cliffporter/SD2-StudyBuddy/Website/pictures/idris-photo.jpg

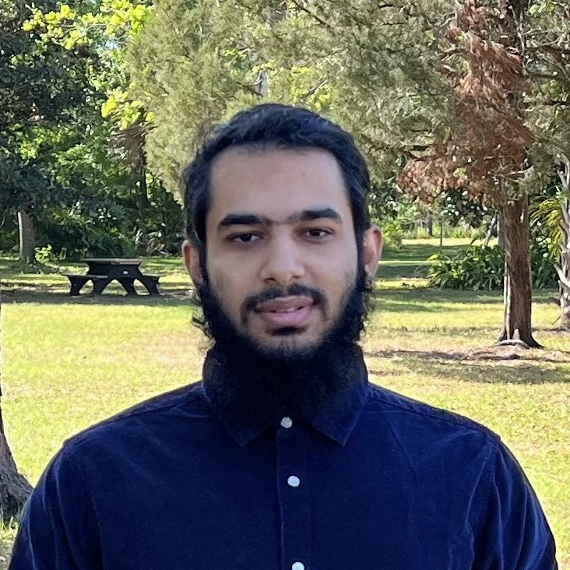
Website/pictures/idris-photo.jpg
