cliffporter/SD2-StudyBuddy/Website/pictures/locker-pcb.jpg

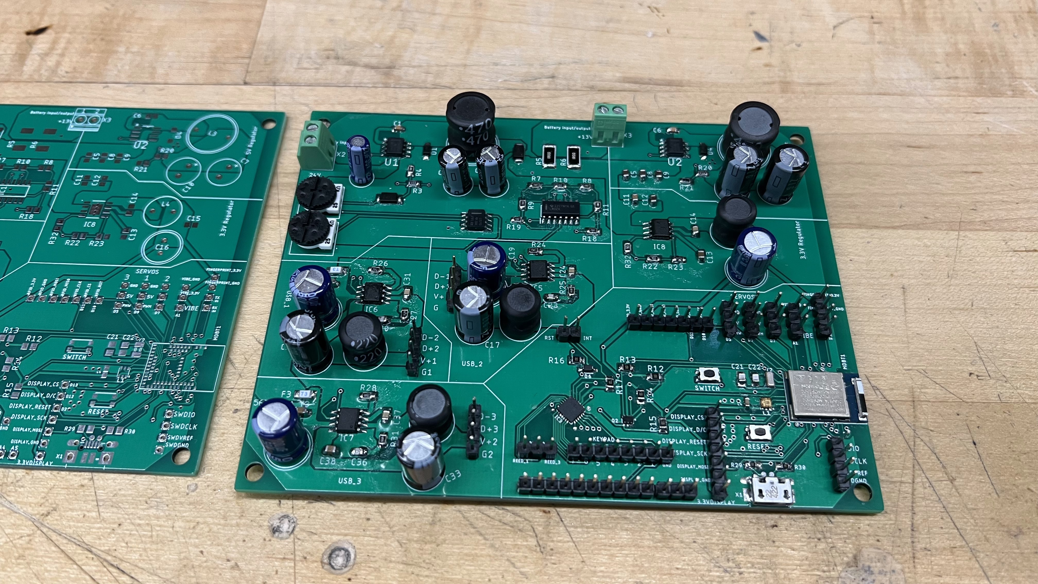
Website/pictures/locker-pcb.jpg
