cliffporter/SD2-StudyBuddy/Website/documents/sd1-dc-thumb.png

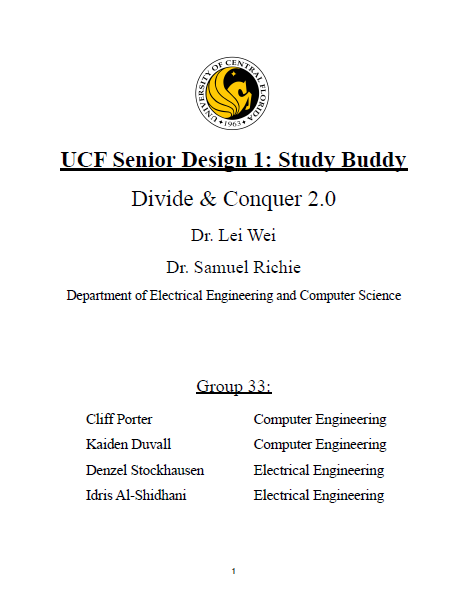
Website/documents/sd1-dc-thumb.png
