cliffporter/SD2-StudyBuddy/Website/documents/sd1-final-doc-thumb.png

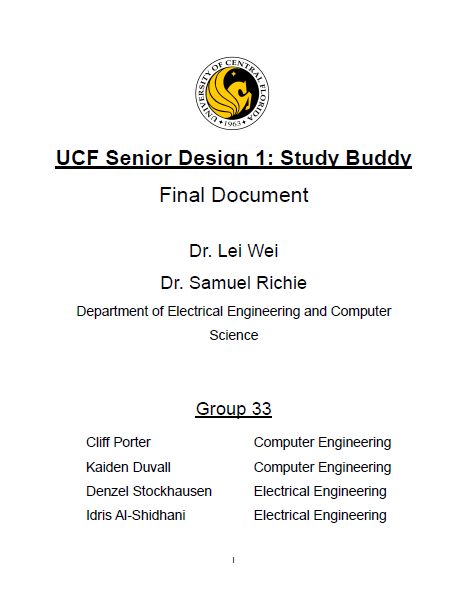
Website/documents/sd1-final-doc-thumb.png
