cliffporter/SD2-StudyBuddy/Website/documents/sd2-8-page-thumb.png

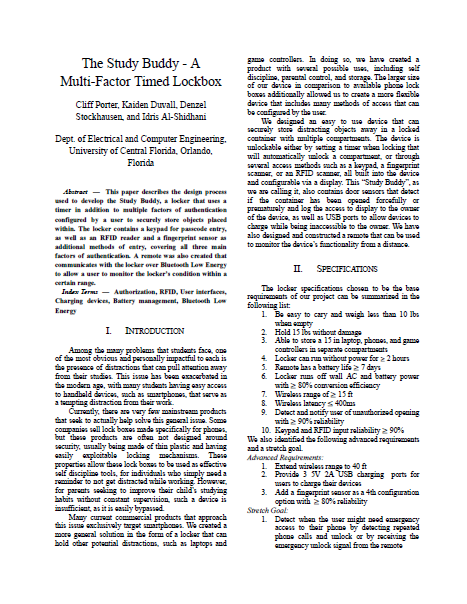
Website/documents/sd2-8-page-thumb.png
