cliffporter/SD2-StudyBuddy/Website/documents/sd2-pres-thumb.png

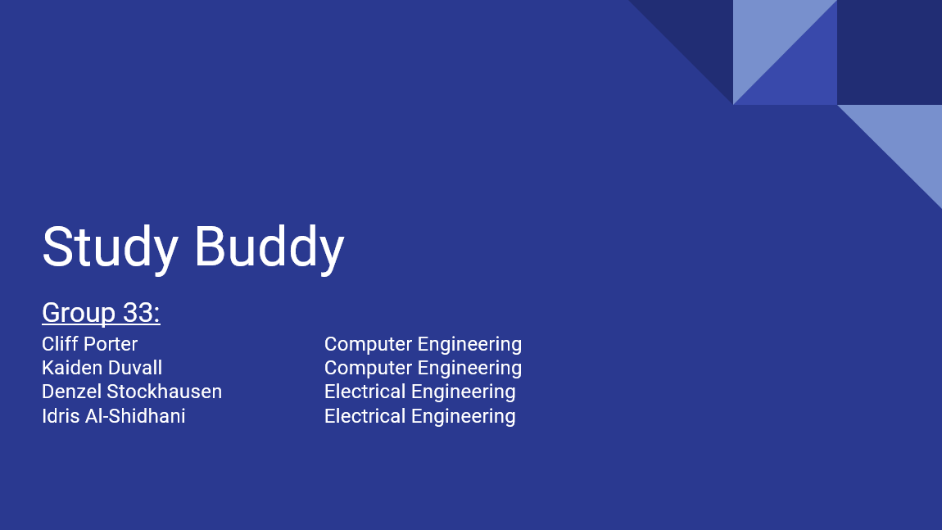
Website/documents/sd2-pres-thumb.png
