cliffporter/SD2-StudyBuddy/Website/pictures/board-and-panel.jpg

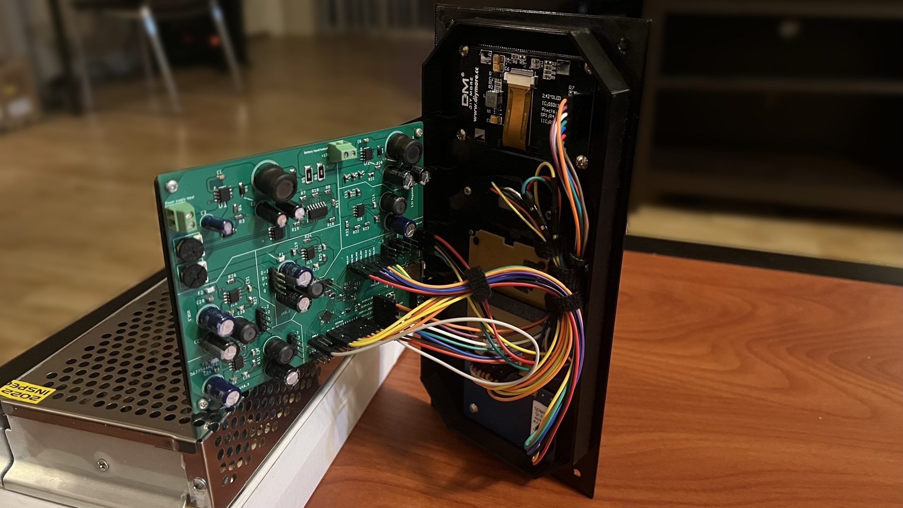
Website/pictures/board-and-panel.jpg
