cliffporter/SD2-StudyBuddy/Website/pictures/cliff-photo.png

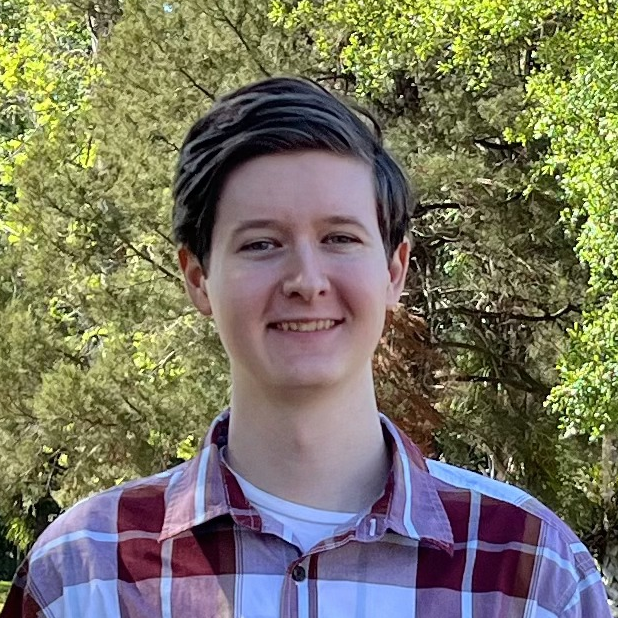
Website/pictures/cliff-photo.png
