cliffporter/SD2-StudyBuddy/Website/pictures/denzel-photo.png

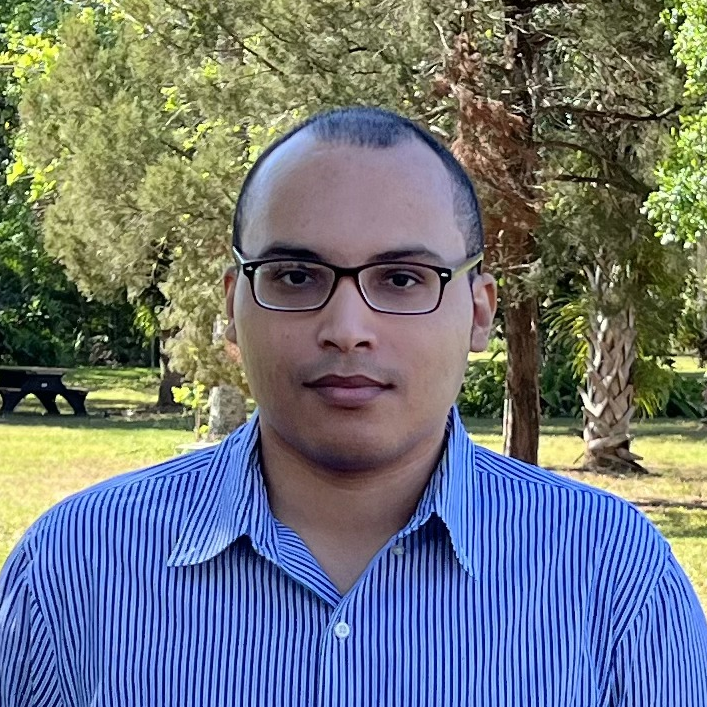
Website/pictures/denzel-photo.png
