cliffporter/SD2-StudyBuddy/Website/pictures/group-photo.jpeg

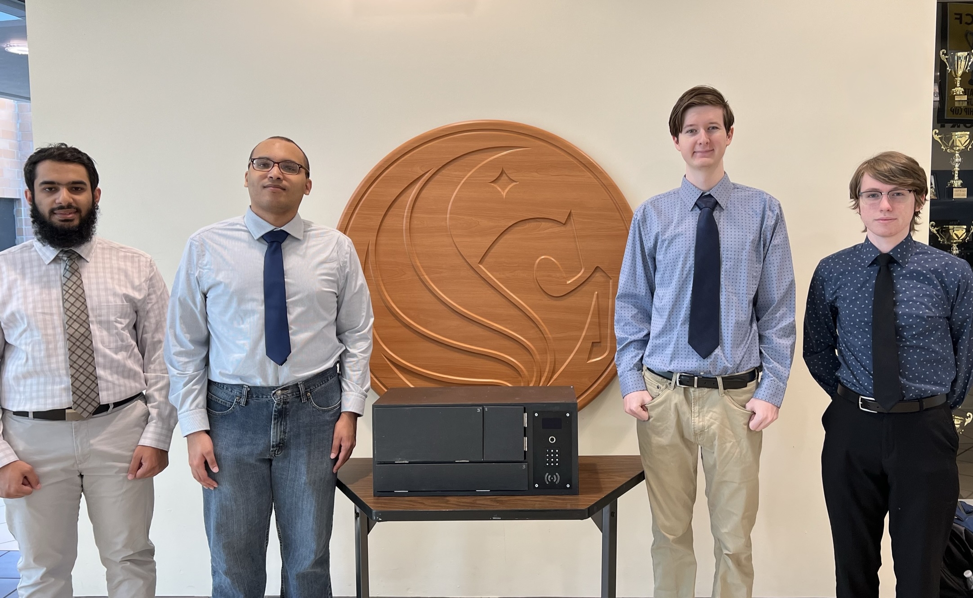
Website/pictures/group-photo.jpeg
