cliffporter/SD2-StudyBuddy/Website/pictures/interface-back.PNG

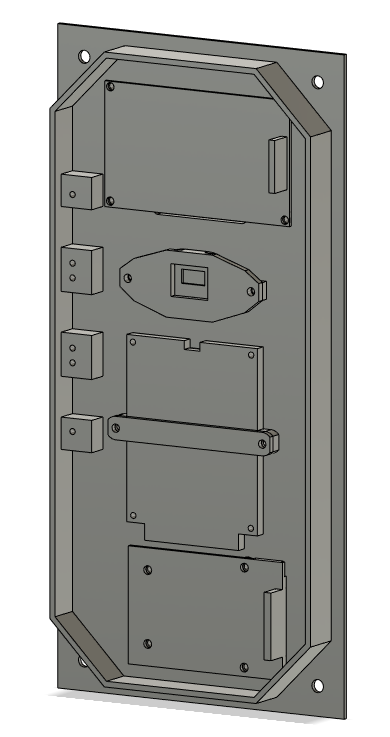
Website/pictures/interface-back.PNG
