cliffporter/SD2-StudyBuddy/Website/pictures/interface.PNG

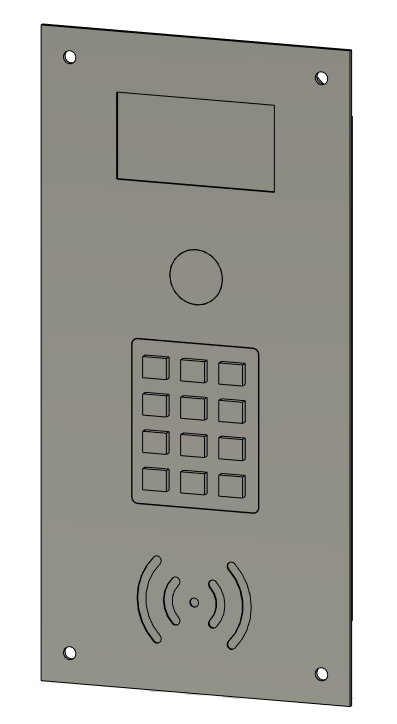
Website/pictures/interface.PNG
