cliffporter/SD2-StudyBuddy/Website/pictures/kaiden-photo.png

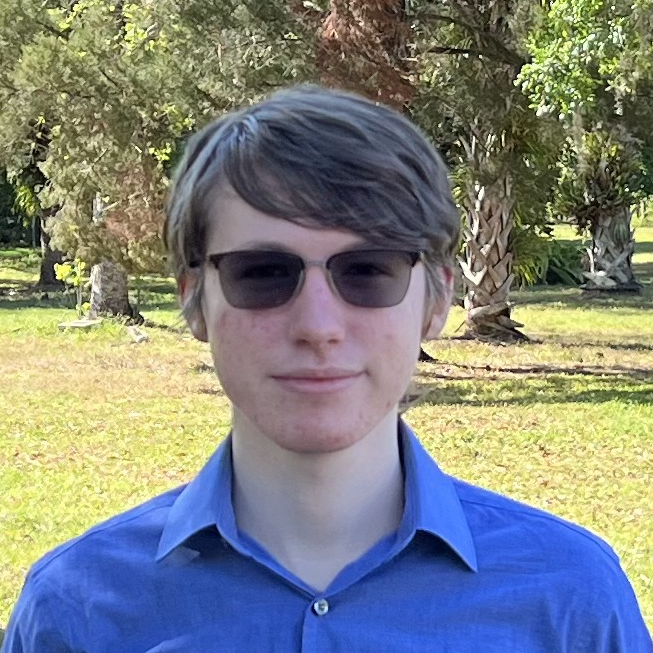
Website/pictures/kaiden-photo.png
