cliffporter/SD2-StudyBuddy/Website/pictures/little-man.png

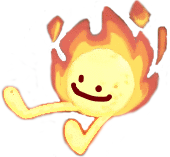
Website/pictures/little-man.png
