cliffporter/SD2-StudyBuddy/Website/pictures/lock-cad.PNG

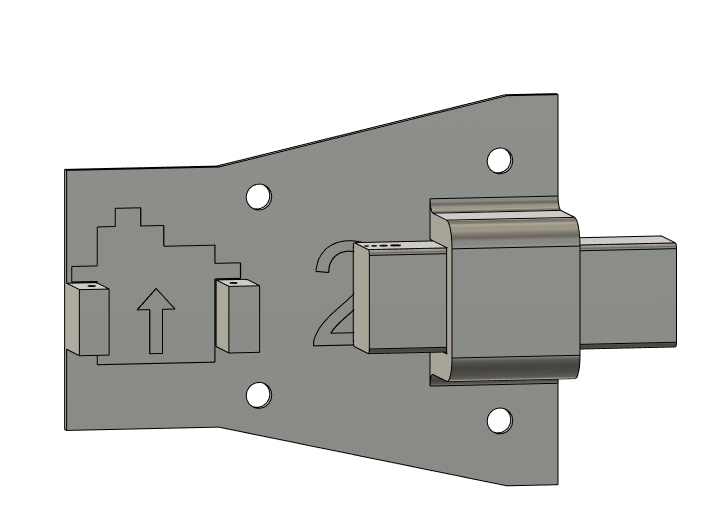
Website/pictures/lock-cad.PNG
