cliffporter/SD2-StudyBuddy/Website/pictures/locker-back.jpeg

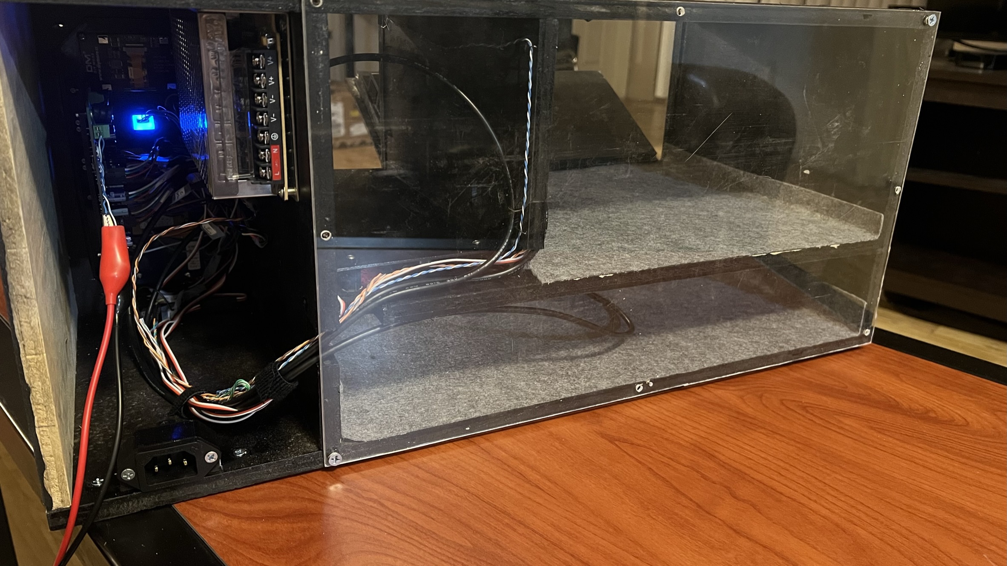
Website/pictures/locker-back.jpeg
