cliffporter/SD2-StudyBuddy/Website/pictures/locker-breadboard.jpg

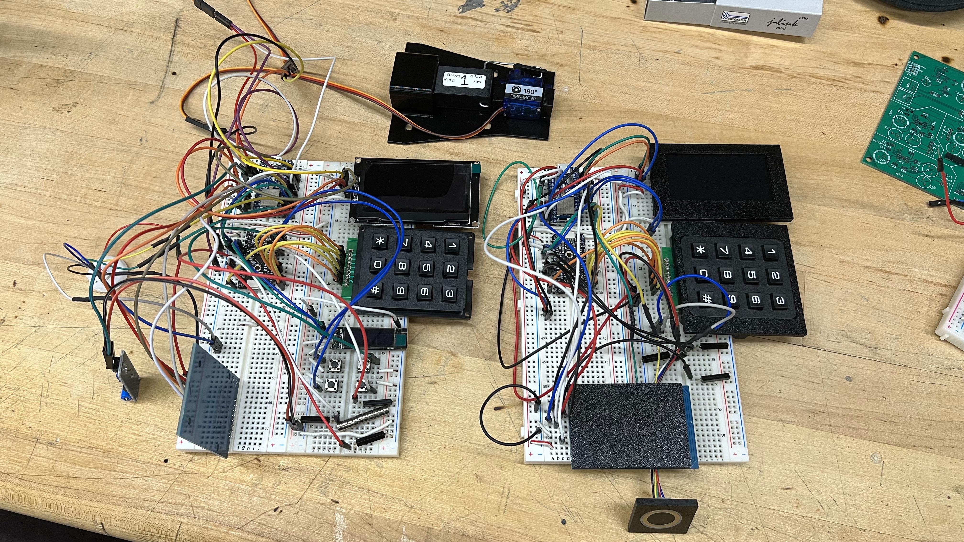
Website/pictures/locker-breadboard.jpg
