cliffporter/SD2-StudyBuddy/Website/pictures/locker-demo-table.jpeg

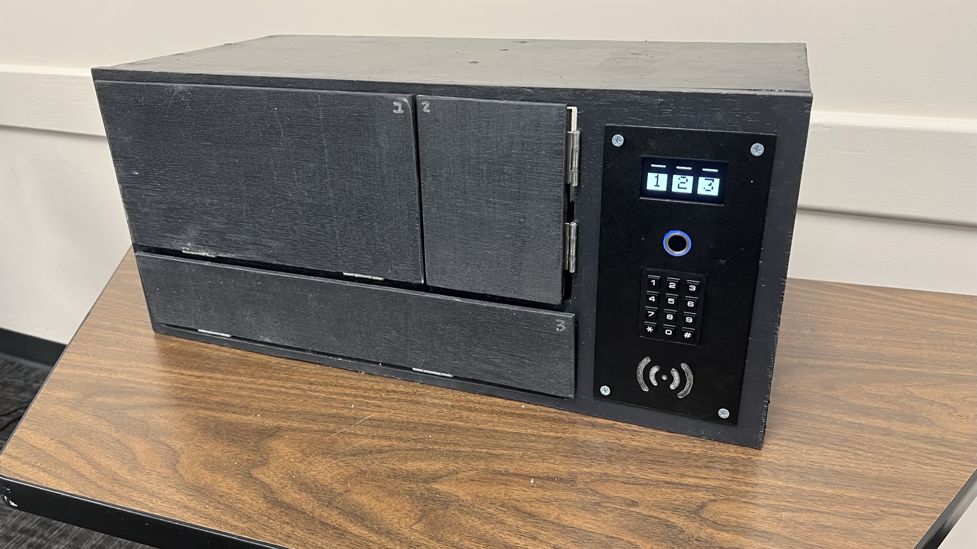
Website/pictures/locker-demo-table.jpeg
