cliffporter/SD2-StudyBuddy/Website/pictures/locker-diagram.png

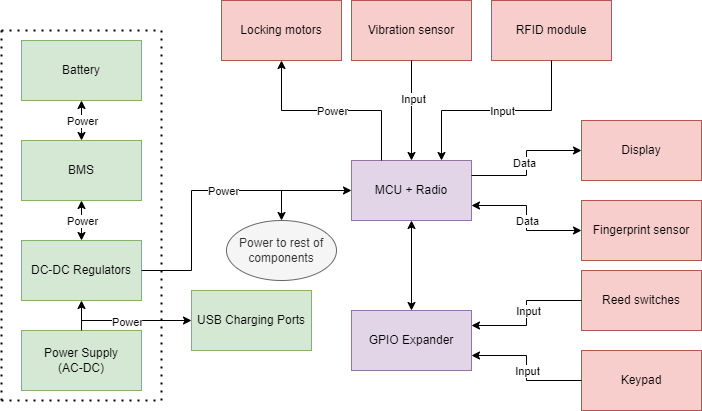
Website/pictures/locker-diagram.png
