cliffporter/SD2-StudyBuddy/Website/pictures/locker-inside.jpeg

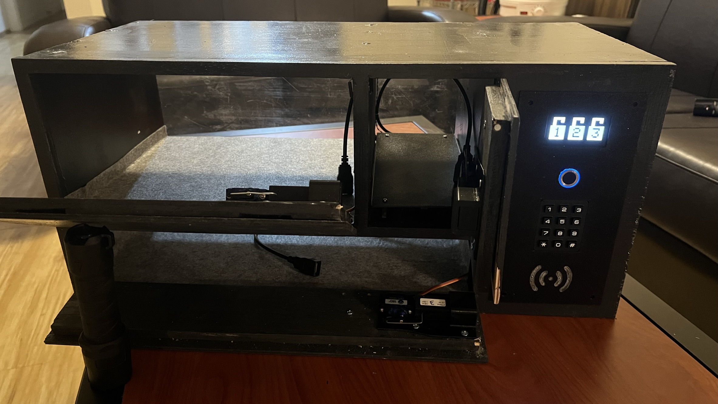
Website/pictures/locker-inside.jpeg
