cliffporter/SD2-StudyBuddy/Website/pictures/locker-table.jpeg

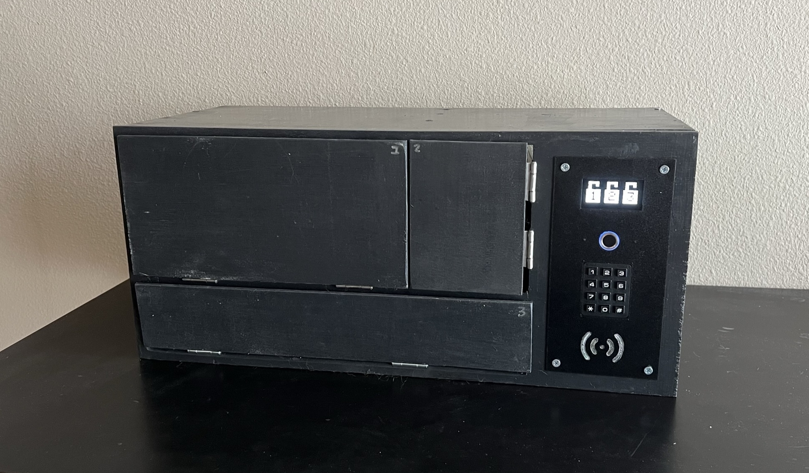
Website/pictures/locker-table.jpeg
