cliffporter/SD2-StudyBuddy/Website/pictures/locking-mech.jpeg

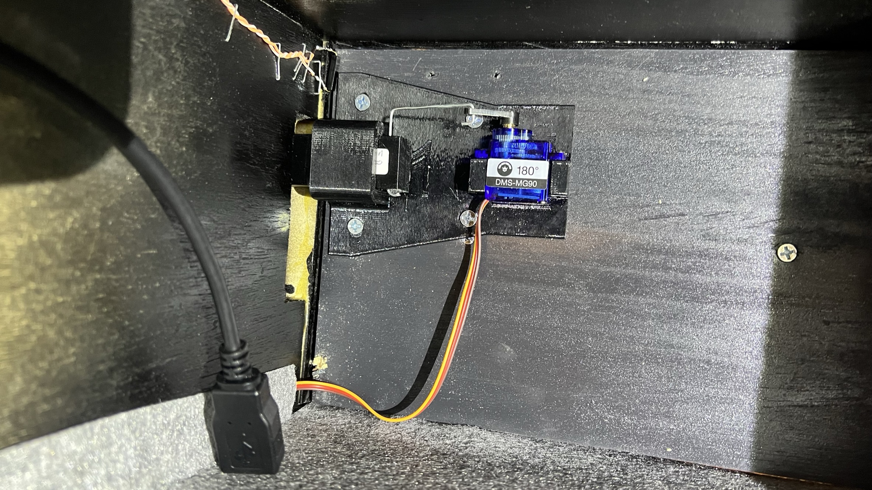
Website/pictures/locking-mech.jpeg
