cliffporter/SD2-StudyBuddy/Website/pictures/locks.jpg

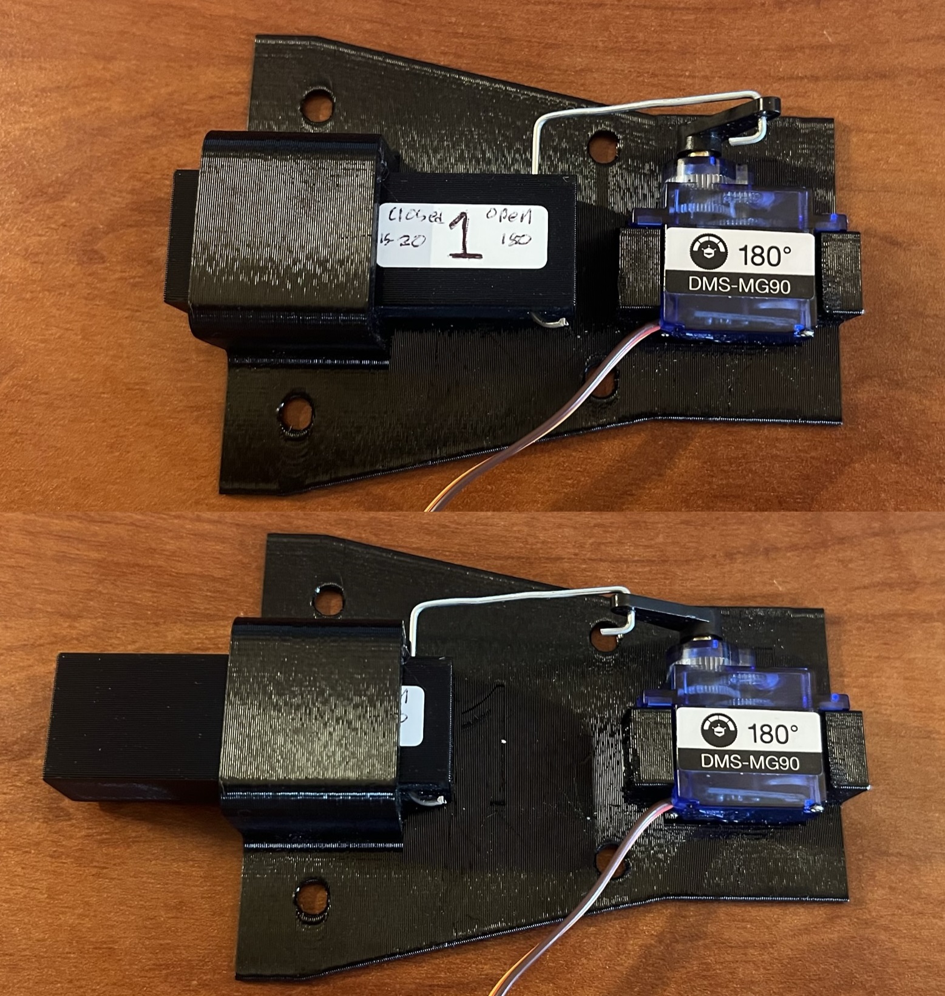
Website/pictures/locks.jpg
