cliffporter/SD2-StudyBuddy/Website/pictures/mspaint.png

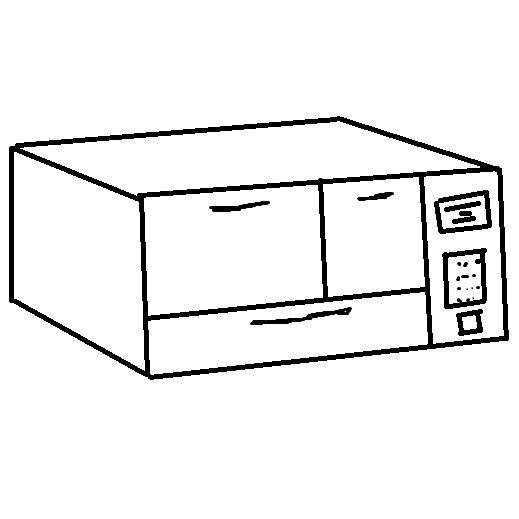
Website/pictures/mspaint.png
