cliffporter/SD2-StudyBuddy/Website/pictures/remote-back-cad.PNG

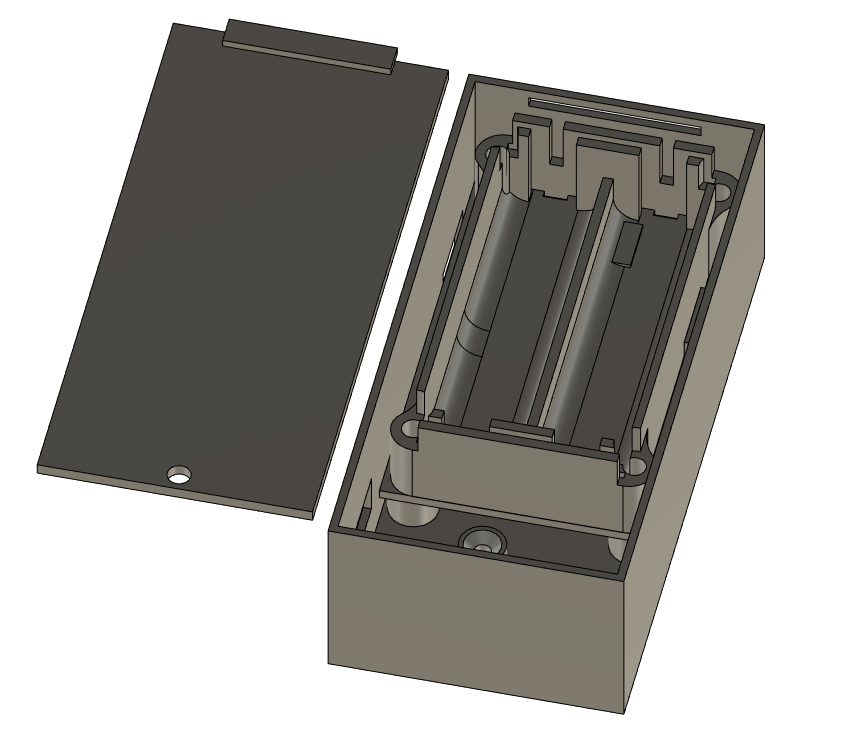
Website/pictures/remote-back-cad.PNG
