cliffporter/SD2-StudyBuddy/Website/pictures/remote-cad.PNG

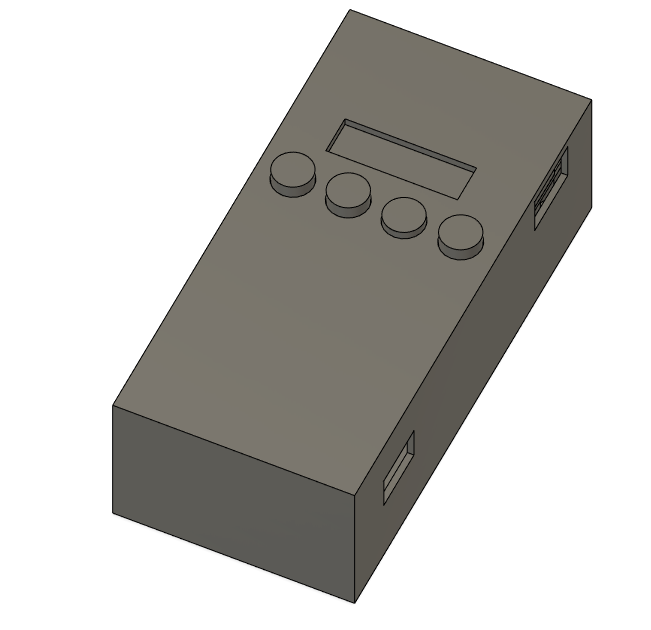
Website/pictures/remote-cad.PNG
