cliffporter/SD2-StudyBuddy/Website/pictures/remote-diagram.png

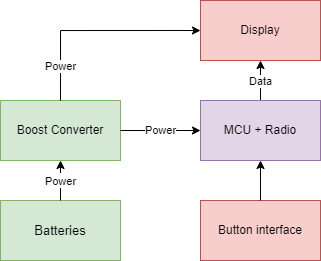
Website/pictures/remote-diagram.png
