cliffporter/SD2-StudyBuddy/Website/pictures/remote-pcb.jpg

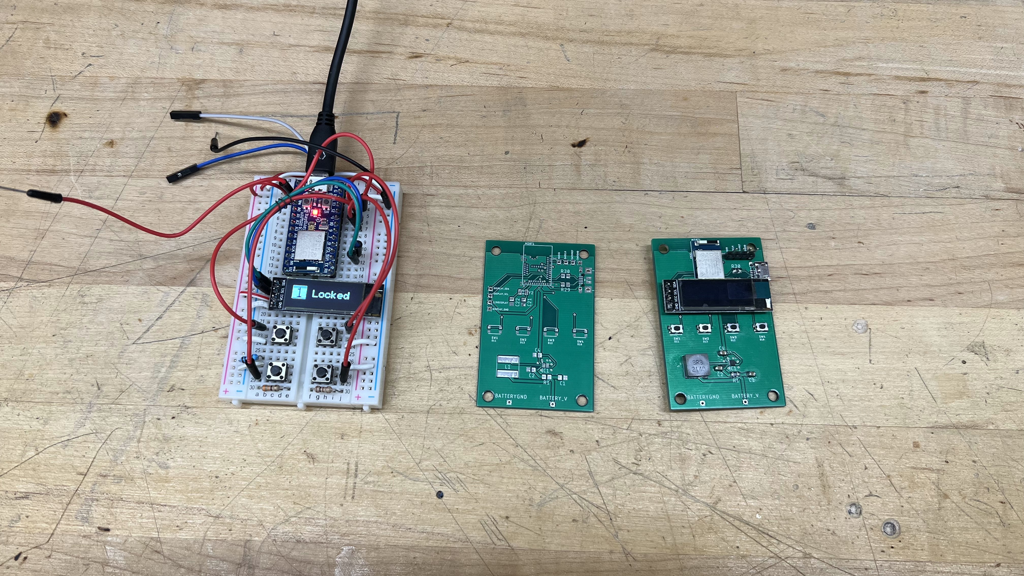
Website/pictures/remote-pcb.jpg
