cliffporter/SD2-StudyBuddy/Website/pictures/remote.jpg

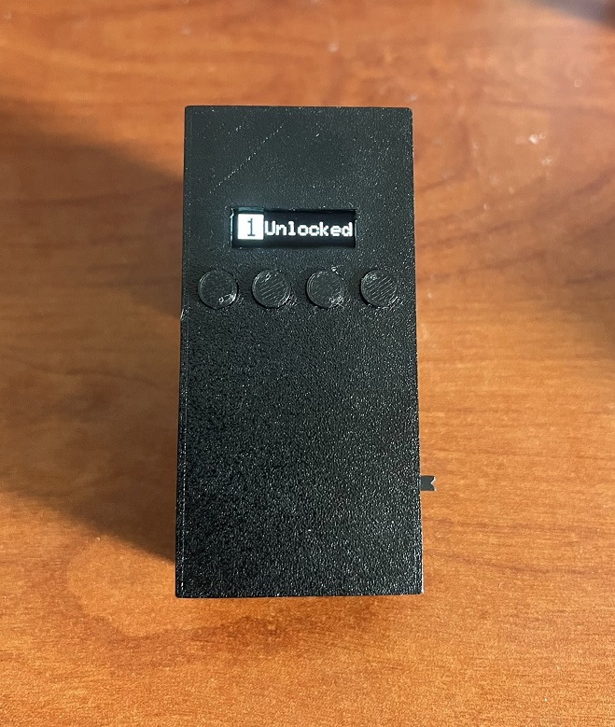
Website/pictures/remote.jpg
