cliffporter/SD2-StudyBuddy/Website/pictures/user-diagram.png

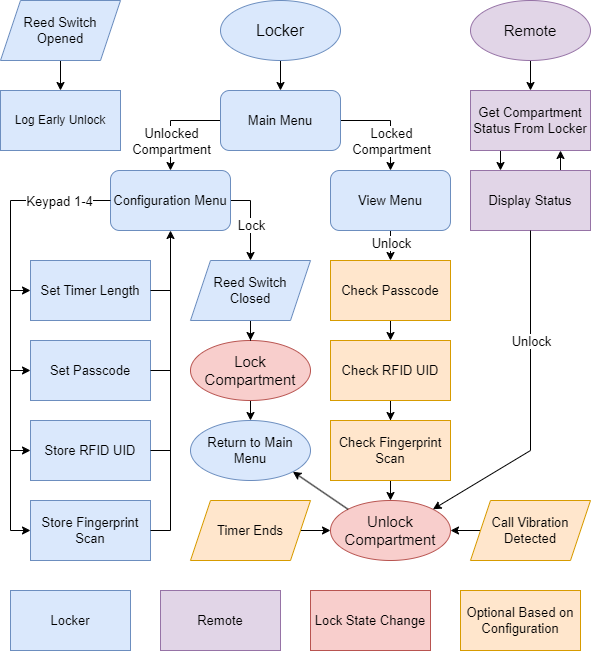
Website/pictures/user-diagram.png
