cliffporter/SD2-StudyBuddy/(commit log)

2023-03-09 main code: basic timer, RFID scanning + cleanup
2023-03-16 full timer, rfid and servo functionality
2023-03-16 Keypad, pin input and reed switches
2023-03-16 Added combined fingerprint code file
2023-03-17 added reed switches and vibration test
    [StudyBuddy.ino, VibeSensorTest.ino]
2023-03-17 Updated timer and fingerprint menus
2023-03-17 Fixed timer menu flicker
    [LockerMenus.ino]
2023-03-24 Added vibe code to main and made pcb test
2023-03-31 set A0 to GND to wait for serial
2023-04-02 error messages for startup
    [StudyBuddy.ino]
2023-04-05 Added lock/unlock positions per motor
2023-04-05 Added remot main and fixed timer display
    [RemoteMain.ino, StudyBuddy.ino]
2023-04-07 servo set postion test script
